goppend/nanoReflowController/hardware/local_libraries/FUSE_0PTF0078P_LTF.step

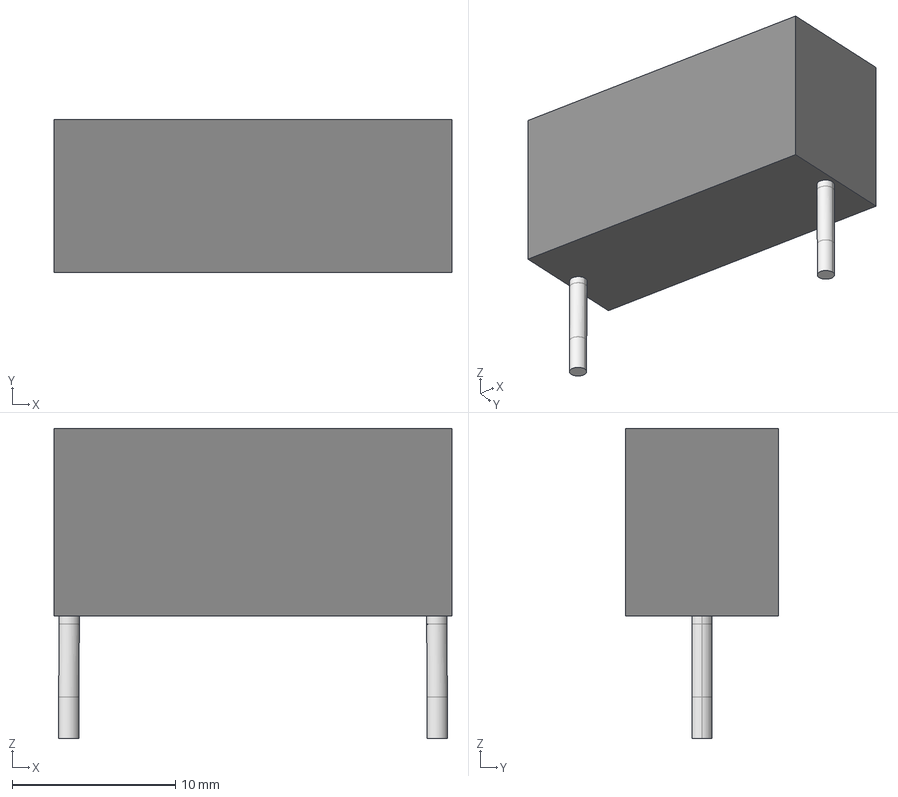
[picture p1: CAD file, 2025-01-18]
hardware/local_libraries/FUSE_0PTF0078P_LTF.step
24.4 x 9.40 x 19.0 mm
