goppend/nanoReflowController/hardware/local_libraries/19x10x3.5.stp

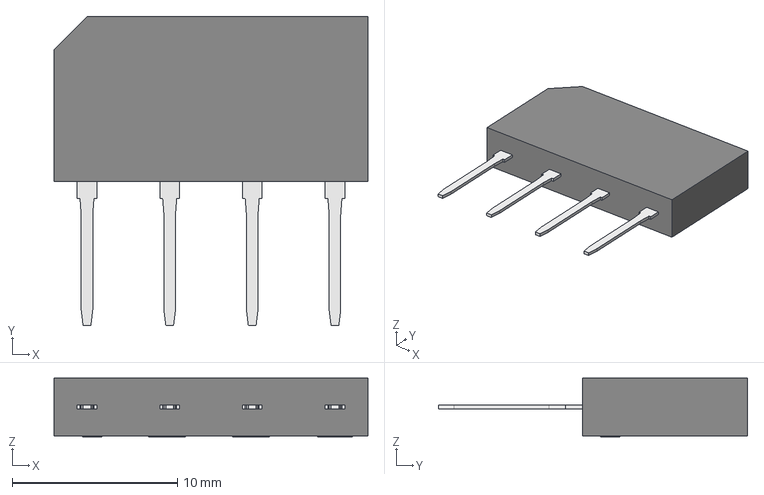
[picture p2: CAD file, 2025-01-13]
hardware/local_libraries/19x10x3.5.stp
19.0 x 18.7 x 3.55 mm
