goppend/nanoReflowController/hardware/arduino_nano_reflow_TRIAC_v1_0.kicad_pcb

## KiCad design hardware/arduino_nano_reflow_TRIAC_v1_0.kicad_pcb (2025-01-18)

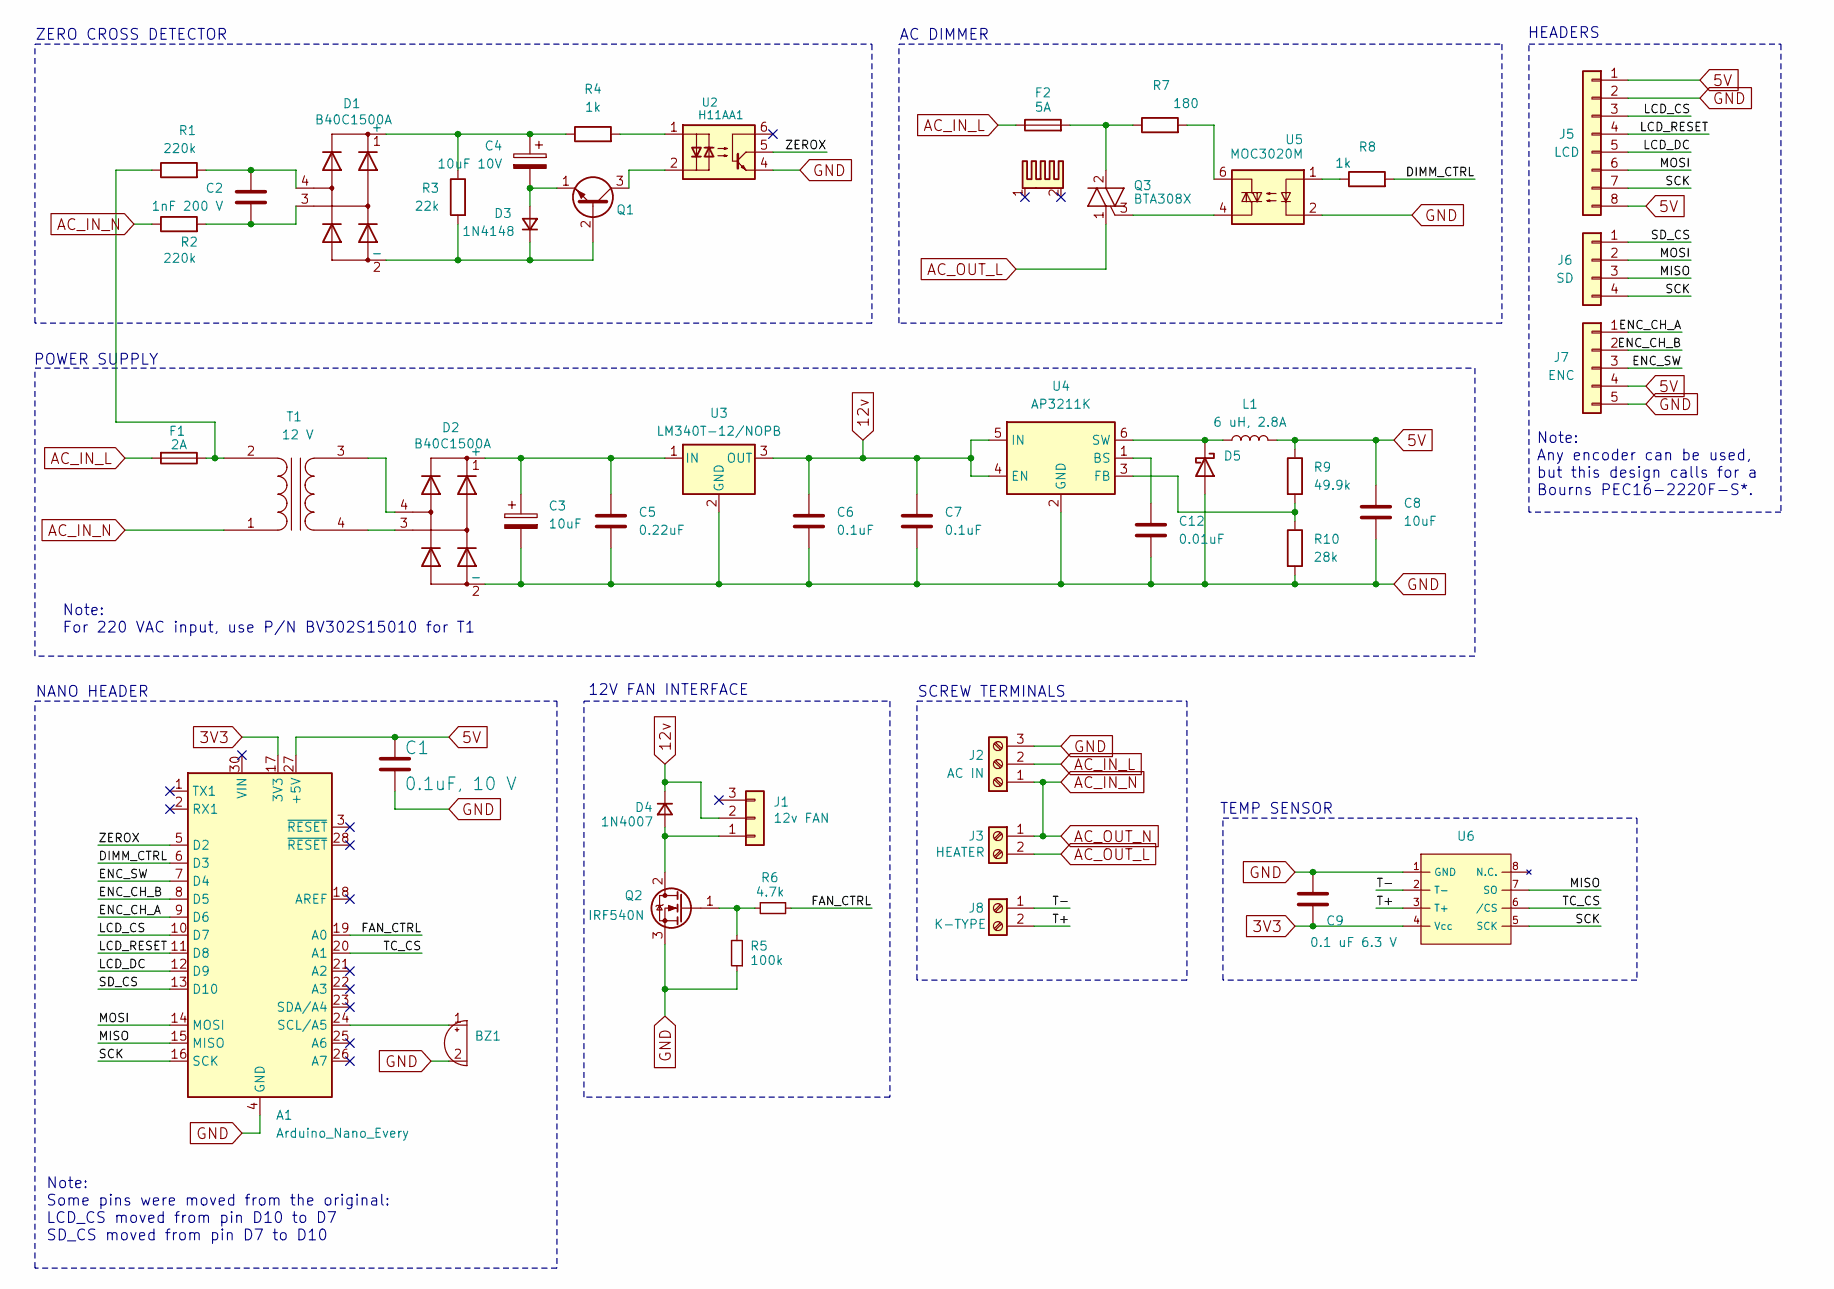
[picture p3: schematic arduino_nano_reflow_TRIAC_v1_0.kicad_sch, Nano Reflow Controller+]

Parts:
A1: Arduino_Nano_Every; Arduino_Nano
BZ1: Buzzer_TDK_PS1240P02BT_D12.2mm_H6.5mm; Part Number WT-1205
C1: 0.1uF, 10 V; C_0805_2012Metric_Pad1.18x1.45mm_HandSolder; Part Number C0805C104K8RACTU
C2: 1nF 200 V; C_Rect_L7.2mm_W2.5mm_P5.00mm_FKS2_FKP2_MKS2_MKP2; Part Number R82MC1100DQ50K
C3: 10uF; CP_Radial_D5.0mm_P2.00mm; Part Number ESS106M025AB2AA
C4: 10uF 10V; CP_Radial_D5.0mm_P2.00mm; Part Number ESK106M010AC3AA
C5: 0.22uF; C_0805_2012Metric_Pad1.18x1.45mm_HandSolder; Part Number C0805C224MMREC7210
C6, C7: 0.1uF; C_0805_2012Metric_Pad1.18x1.45mm_HandSolder; Part Number C0805C104K3RACTU
C8: 10uF; C_0805_2012Metric_Pad1.18x1.45mm_HandSolder; Part Number C0805C106K9PACTU
C9: 0.1 uF 6.3 V; C_0805_2012Metric_Pad1.18x1.45mm_HandSolder; Part Number C0805C104K9RACTU
C12: 0.01uF; C_0805_2012Metric_Pad1.18x1.45mm_HandSolder; Part Number C0805C103K8RACTU
D1, D2: B40C1500A; B40C; Part Number B40C1500A
D3: 1N4148; D_DO-35_SOD27_P7.62mm_Horizontal; Part Number 1N4148
D4: 1N4007; D_DO-35_SOD27_P7.62mm_Horizontal; Part Number 1N4007
D5: 40V, 2A; D_SMA_Handsoldering; Part Number B240A-13-F
F1: 2A; FUSE_0PTF0078P_LTF; Part Number 0PTF0078P
F2: 5A; FUSE_0PTF0078P_LTF; Part Number 0PTF0078P
HS1: Aavid 51300 Heatsink; Part Number 513102B02500G
J1: 12v FAN; FanPinHeader_1x03_P2.54mm_Vertical; Part Number 640456-3
J2: AC IN; TerminalBlock_Phoenix_MKDS-1,5-3_1x03_P5.00mm_Horizontal; Part Number 1727023
J3: HEATER; TerminalBlock_Phoenix_MKDS-1,5-2_1x02_P5.00mm_Horizontal; Part Number 1727010
J5: LCD; PinHeader_1x08_P2.54mm_Vertical; Part Number M20-9990846
J6: SD; PinHeader_1x04_P2.54mm_Vertical; Part Number M20-9990546
J7: ENC; PinHeader_1x05_P2.54mm_Vertical; Part Number M20-9990546
J8: K-TYPE; TerminalBlock_Phoenix_MKDS-1,5-2_1x02_P5.00mm_Horizontal; Part Number 1727010
L1: 6 uH, 2.8A; Bourns SRN6028C Inductor hand solder; Part Number SRN6028C-6R0M
Q1: 40V, 0.8A; TO-92_Inline_Wide; Part Number PN2222A PBFREE
Q2: IRF540N; TO-220-3_Vertical; Part Number IRF540N
Q3: BTA308X; TO-220-3_Vertical; Part Number BTA308X
R1, R2: 220k; R_Axial_DIN0204_L3.6mm_D1.6mm_P5.08mm_Horizontal; Part Number CF18JT220K
R3: 22k; R_Axial_DIN0204_L3.6mm_D1.6mm_P5.08mm_Horizontal; Part Number CF18JT22K0
R4, R8: 1k; R_Axial_DIN0204_L3.6mm_D1.6mm_P5.08mm_Horizontal; Part Number CF18JT1K00
R5: 100k; R_Axial_DIN0204_L3.6mm_D1.6mm_P5.08mm_Horizontal; Part Number CF18JT100K
R6: 4.7k; R_Axial_DIN0204_L3.6mm_D1.6mm_P5.08mm_Horizontal; Part Number CF18JT4K70
R7: 180; R_Axial_DIN0207_L6.3mm_D2.5mm_P7.62mm_Horizontal; Part Number CF18JT180R
R9: 49.9k; R_0805_2012Metric_Pad1.20x1.40mm_HandSolder; Part Number RK73H2ATTD4992F
R10: 28k; R_0805_2012Metric_Pad1.20x1.40mm_HandSolder; Part Number RK73H2ATTD2802F
T1: 12 V; BV301S15010; Part Number BV301S15010
U2: H11AA1; DIP-6_W7.62mm; Part Number H11AA1
U3: LM340T-12/NOPB; TO-263-3_TabPin4; Part Number LM340T-12/NOPB
U4: AP3211K; SOT-23-6_Handsoldering; Part Number AP3211K
U5: MOC3020M; DIP-6_W7.62mm_Socket_LongPads; Part Number MOC3020M
U6: SO-8_3.9x4.9mm_P1.27mm; Part Number MAX6675

Connections:
3V3: A1.17 (3V3), C9.2, U6.4 (Vcc)
5V: A1.27 (+5V), C1.1, C8.1, J5.1, J5.8, J7.4, L1.2, R9.1
12v: C6.1, C7.1, D4.1 (K), J1.2, U3.3 (OUT), U4.4 (EN), U4.5 (IN)
/DIMM_CTRL: A1.6 (D3), R8.2
/ENC_CH_A: A1.9 (D6), J7.1
/ENC_CH_B: A1.8 (D5), J7.2
/ENC_SW: A1.7 (D4), J7.3
/FAN_CTRL: A1.19 (A0), R6.1
/LCD_CS: A1.10 (D7), J5.3
/LCD_DC: A1.12 (D9), J5.5
/LCD_RESET: A1.11 (D8), J5.4
/MISO: A1.15 (MISO), J6.3, U6.7 (SO)
/MOSI: A1.14 (MOSI), J5.6, J6.2
/SCK: A1.16 (SCK), J5.7, J6.4, U6.5 (SCK)
/SD_CS: A1.13 (D10), J6.1
/T+: J8.2, U6.3 (T+)
/T-: J8.1, U6.2 (T-)
/TC_CS: A1.20 (A1), U6.6 (/CS)
/ZEROX: A1.5 (D2), U2.5
AC_IN_L: F1.2, F2.1, J2.2
AC_IN_N: J2.1, J3.1, R2.1, T1.1 (AA)
AC_OUT_L: J3.2, Q3.1 (A1)
GND: A1.4 (GND), A1.29 (GND), BZ1.2 (+), C1.2, C3.2, C5.2, C6.2, C7.2, C8.2, C9.1, C12.2, D2.2 (-), D5.2 (A), J2.3, J5.2, J7.5, Q2.3 (S), R5.1, R10.2, U2.4, U3.2 (GND), U4.2 (GND), U5.2, U6.1 (GND)
unnamed: A1.24 (SCL/A5), BZ1.1 (-)
unnamed: C2.1, D1.4, R1.2
unnamed: C2.2, D1.3, R2.2
unnamed: C4.1, D1.1 (+), R3.1, R4.1
unnamed: D1.2 (-), D3.1 (K), Q1.2 (B), R3.2
unnamed: C3.1, C5.1, D2.1 (+), U3.1 (IN)
unnamed: C4.2, D3.2 (A), Q1.1 (E)
unnamed: D4.2 (A), J1.1, Q2.2 (D)
unnamed: D5.1 (K), L1.1, U4.6 (SW)
unnamed: Q1.3 (C), U2.2
unnamed: Q2.1 (G), R5.2, R6.2
unnamed: F2.2, Q3.2 (A2), R7.1
unnamed: Q3.3 (G), U5.4
unnamed: R4.2, U2.1
unnamed: R7.2, U5.6
unnamed: R8.1, U5.1
unnamed: F1.1, R1.1, T1.2 (AB)
unnamed: D2.4, T1.3 (SA)
unnamed: D2.3, T1.4 (SB)
unnamed: C12.1, U4.1 (BS)
unnamed: R9.2, R10.1, U4.3 (FB)

Notes on the sheet:
AC DIMMER
ZERO CROSS DETECTOR
Note: Any encoder can be used, but this design calls for a Bourns PEC16-2220F-S*.
HEADERS
Note: Some pins were moved from the original: LCD_CS moved from pin D10 to D7 SD_CS moved from pin D7 to D10
SCREW TERMINALS
TEMP SENSOR
Note: For 220 VAC input, use P/N BV302S15010 for T1
POWER SUPPLY
NANO HEADER
12V FAN INTERFACE

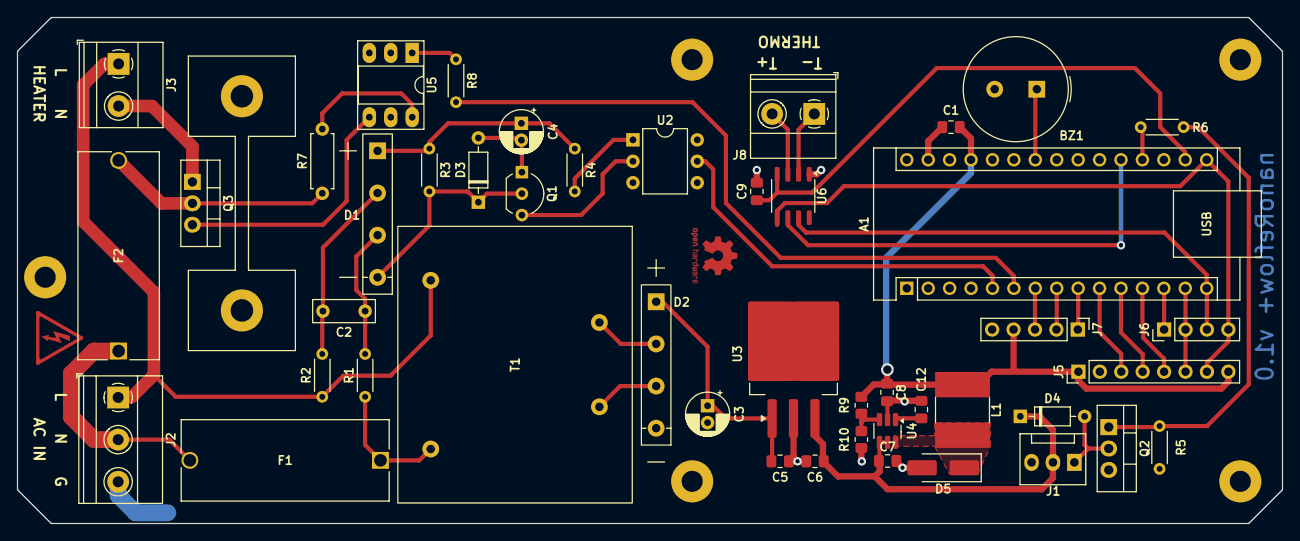
[picture p4: board arduino_nano_reflow_TRIAC_v1_0.kicad_pcb from above]

Board: 2 copper layers, 150.0 x 60.0 mm, 47 parts (0 on the bottom side), 44 nets.
