goppend/nanoReflowController/(commit log)

2019-07-02 add TimerOne submodule
2019-11-09 Auto calibrate mains freq and loop delay, reduce TIMER1_PERIOD_US
2025-01-12 Extract project to track changes and update to KiCad 8
    [arduino_nano_reflow_TRIAC_v1_0.kicad_pcb, arduino_nano_reflow_TRIAC_v1_0.kicad_sch]
2025-01-13 Update schematic: Reorganized and added AC power supply.
    [19x10x3.5.stp, arduino_nano_reflow_TRIAC_v1_0.kicad_sch]
2025-01-18 Big update. Lots of schematic reorg and mostly final PCB layout. Updated zero crossing detector to be more accurate and added temp sensor on board instead of a connector to a separate module. Moved s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
    [FUSE_0PTF0078P_LTF.step, arduino_nano_reflow_TRIAC_v1_0.kicad_pcb, arduino_nano_reflow_TRIAC_v1_0.kicad_sch]
2025-01-18 Some small changes I forgot in the last commit, and an updated BOM.
    [arduino_nano_reflow_TRIAC_v1_0.kicad_pcb, v1_0+_bom.csv]
2025-01-18 Fixed grid in PCB, minor movement changes, and fixed DRC issues.
    [arduino_nano_reflow_TRIAC_v1_0.kicad_pcb]
